bryanduxbury/cellular_chronometer/scad/button_flange.dxf

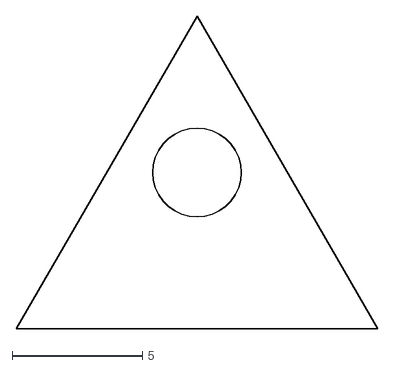
[picture p1: CAD file, 2014-02-02]
scad/button_flange.dxf
13.9 x 12.0
