bryanduxbury/cellular_chronometer/scad/support.dxf

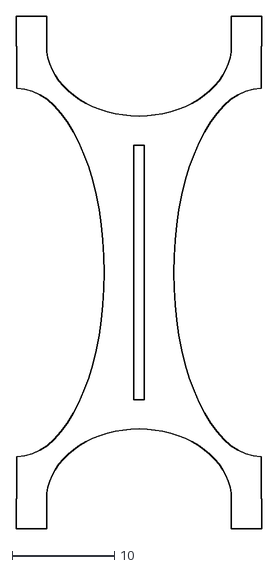
[picture p2: CAD file, 2014-02-02]
scad/support.dxf
24.0 x 50.1
