bryanduxbury/cellular_chronometer/scad/side.dxf

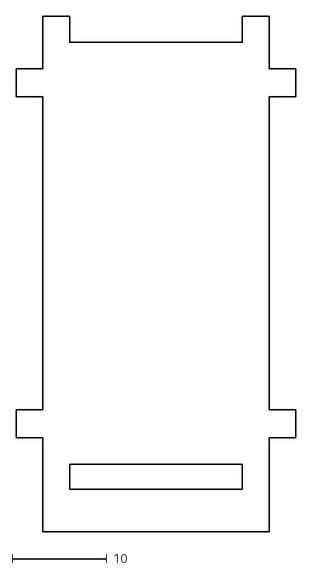
[picture p3: CAD file, 2014-02-02]
scad/side.dxf
29.5 x 54.4
