bryanduxbury/cellular_chronometer/scad/button.dxf

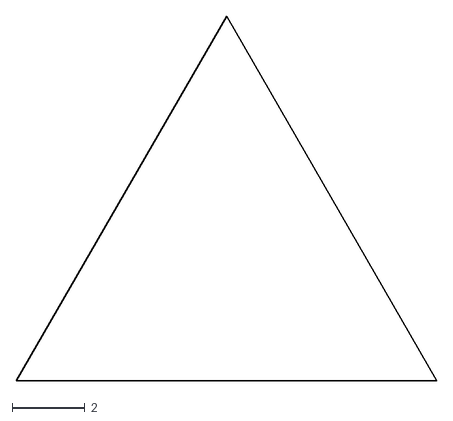
[picture p4: CAD file, 2014-02-02]
scad/button.dxf
11.5 x 10.0
