bryanduxbury/cellular_chronometer/scad/back.dxf

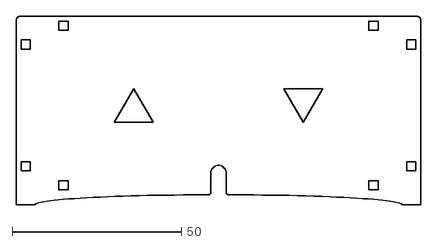
[picture p5: CAD file, 2014-02-02]
scad/back.dxf
119.6 x 55.8
