bryanduxbury/cellular_chronometer/scad/topbottom.dxf

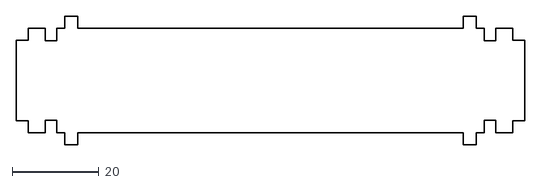
[picture p6: CAD file, 2014-02-02]
scad/topbottom.dxf
116.9 x 29.5
