bryanduxbury/cellular_chronometer/scad/front.dxf

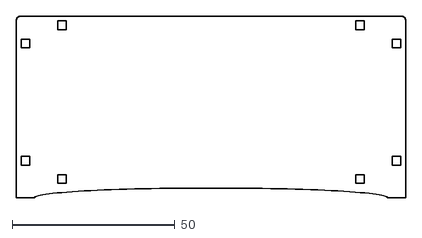
[picture p7: CAD file, 2014-02-02]
scad/front.dxf
119.6 x 55.8
