bryanduxbury/cellular_chronometer/eagle/charlie_array_v1/charlie_array_0805_v1.brd

## EAGLE design eagle/charlie_array_v1/charlie_array_0805_v1.brd (2013-08-26)

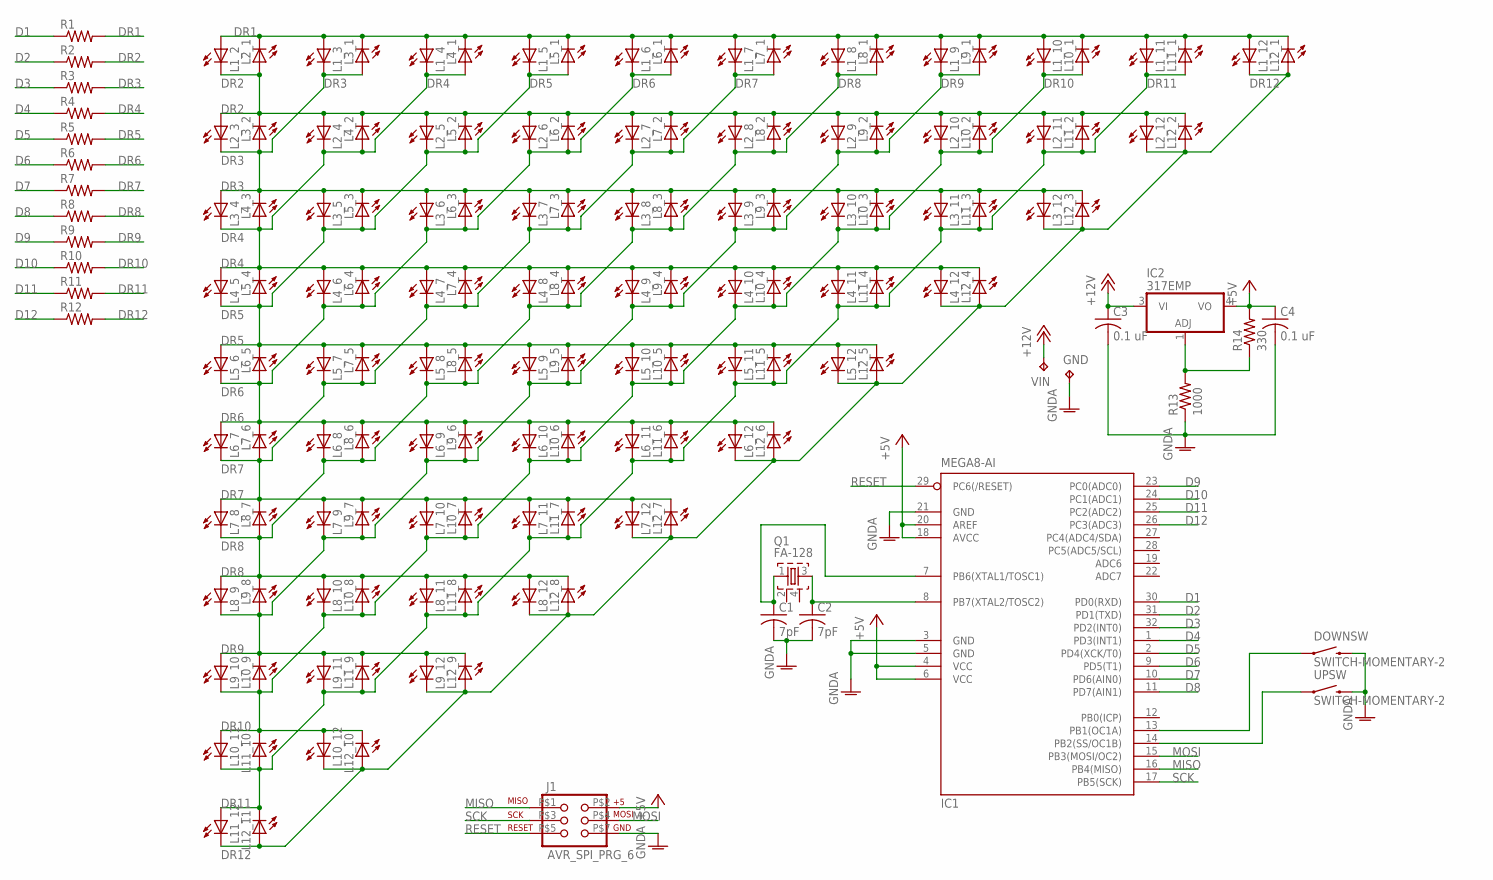
[picture p8: schematic charlie_array_0805_v1.sch]

Parts:
C1, C2: 7pF; C0603
C3, C4: 0.1 uF; C0603
DOWNSW: SWITCH-MOMENTARY-2; TACTILE_SWITCH_TALL
GND: TPTP20SQ; TP20SQ
IC1: MEGA8-AI; TQFP32-08
IC2: 317EMP; SOT223
J1: AVR_SPI_PRG_6; 2X3_ICSP_SMD
L1_2, L1_3, L1_4, L1_5, L1_6, L1_7, L1_8, L1_9, L1_10, L1_11, L1_12, L2_1, L2_3, L2_4, L2_5, L2_6, L2_7, L2_8, L2_9, L2_10, L2_11, L2_12, L3_1, L3_2, L3_4, L3_5, L3_6, L3_7, L3_8, L3_9, L3_10, L3_11, L3_12, L4_1, L4_2, L4_3, L4_5, L4_6, L4_7, L4_8, L4_9, L4_10, L4_11, L4_12, L5_1, L5_2, L5_3, L5_4, L5_6, L5_7, L5_8, L5_9, L5_10, L5_11, L5_12, L6_1, L6_2, L6_3, L6_4, L6_5, L6_7, L6_8, L6_9, L6_10, L6_11, L6_12, L7_1, L7_2, L7_3, L7_4, L7_5, L7_6, L7_8, L7_9, L7_10, L7_11, L7_12, L8_1, L8_2, L8_3, L8_4, L8_5, L8_6, L8_7, L8_9, L8_10, L8_11, L8_12, L9_1, L9_2, L9_3, L9_4, L9_5, L9_6, L9_7, L9_8, L9_10, L9_11, L9_12, L10_1, L10_2, L10_3, L10_4, L10_5, L10_6, L10_7, L10_8, L10_9, L10_11, L10_12, L11_1, L11_2, L11_3, L11_4, L11_5, L11_6, L11_7, L11_8, L11_9, L11_10, L11_12, L12_1, L12_2, L12_3, L12_4, L12_5, L12_6, L12_7, L12_8, L12_9, L12_10, L12_11: LEDCHIPLED_0805; CHIPLED_0805
Q1: FA-128
R1, R2, R3, R4, R5, R6, R7, R8, R9, R10, R11, R12: R-US_R0603; R0603
R13: 1000; R0603
R14: 330; R0603
UPSW: SWITCH-MOMENTARY-2; TACTILE_SWITCH_TALL
VIN: TPTP20SQ; TP20SQ

Connections:
+5V: C4.1, IC1.4 (VCC), IC1.6 (VCC), IC1.18 (AVCC), IC1.20 (AREF), IC2.4 (VO), J1.P$2 (2), R14.2
+12V: C3.1, IC2.3 (VI), VIN.TP
D1: IC1.30 (PD0(RXD)), R1.1
D2: IC1.31 (PD1(TXD)), R2.1
D3: IC1.32 (PD2(INT0)), R3.1
D4: IC1.1 (PD3(INT1)), R4.1
D5: IC1.2 (PD4(XCK/T0)), R5.1
D6: IC1.9 (PD5(T1)), R6.1
D7: IC1.10 (PD6(AIN0)), R7.1
D8: IC1.11 (PD7(AIN1)), R8.1
D9: IC1.23 (PC0(ADC0)), R9.1
D10: IC1.24 (PC1(ADC1)), R10.1
D11: IC1.25 (PC2(ADC2)), R11.1
D12: IC1.26 (PC3(ADC3)), R12.1
DR1: L1_2.A, L1_3.A, L1_4.A, L1_5.A, L1_6.A, L1_7.A, L1_8.A, L1_9.A, L1_10.A, L1_11.A, L1_12.A, L2_1.C, L3_1.C, L4_1.C, L5_1.C, L6_1.C, L7_1.C, L8_1.C, L9_1.C, L10_1.C, L11_1.C, L12_1.C, R1.2
DR2: L1_2.C, L2_1.A, L2_3.A, L2_4.A, L2_5.A, L2_6.A, L2_7.A, L2_8.A, L2_9.A, L2_10.A, L2_11.A, L2_12.A, L3_2.C, L4_2.C, L5_2.C, L6_2.C, L7_2.C, L8_2.C, L9_2.C, L10_2.C, L11_2.C, L12_2.C, R2.2
DR3: L1_3.C, L2_3.C, L3_1.A, L3_2.A, L3_4.A, L3_5.A, L3_6.A, L3_7.A, L3_8.A, L3_9.A, L3_10.A, L3_11.A, L3_12.A, L4_3.C, L5_3.C, L6_3.C, L7_3.C, L8_3.C, L9_3.C, L10_3.C, L11_3.C, L12_3.C, R3.2
DR4: L1_4.C, L2_4.C, L3_4.C, L4_1.A, L4_2.A, L4_3.A, L4_5.A, L4_6.A, L4_7.A, L4_8.A, L4_9.A, L4_10.A, L4_11.A, L4_12.A, L5_4.C, L6_4.C, L7_4.C, L8_4.C, L9_4.C, L10_4.C, L11_4.C, L12_4.C, R4.2
DR5: L1_5.C, L2_5.C, L3_5.C, L4_5.C, L5_1.A, L5_2.A, L5_3.A, L5_4.A, L5_6.A, L5_7.A, L5_8.A, L5_9.A, L5_10.A, L5_11.A, L5_12.A, L6_5.C, L7_5.C, L8_5.C, L9_5.C, L10_5.C, L11_5.C, L12_5.C, R5.2
DR6: L1_6.C, L2_6.C, L3_6.C, L4_6.C, L5_6.C, L6_1.A, L6_2.A, L6_3.A, L6_4.A, L6_5.A, L6_7.A, L6_8.A, L6_9.A, L6_10.A, L6_11.A, L6_12.A, L7_6.C, L8_6.C, L9_6.C, L10_6.C, L11_6.C, L12_6.C, R6.2
DR7: L1_7.C, L2_7.C, L3_7.C, L4_7.C, L5_7.C, L6_7.C, L7_1.A, L7_2.A, L7_3.A, L7_4.A, L7_5.A, L7_6.A, L7_8.A, L7_9.A, L7_10.A, L7_11.A, L7_12.A, L8_7.C, L9_7.C, L10_7.C, L11_7.C, L12_7.C, R7.2
DR8: L1_8.C, L2_8.C, L3_8.C, L4_8.C, L5_8.C, L6_8.C, L7_8.C, L8_1.A, L8_2.A, L8_3.A, L8_4.A, L8_5.A, L8_6.A, L8_7.A, L8_9.A, L8_10.A, L8_11.A, L8_12.A, L9_8.C, L10_8.C, L11_8.C, L12_8.C, R8.2
DR9: L1_9.C, L2_9.C, L3_9.C, L4_9.C, L5_9.C, L6_9.C, L7_9.C, L8_9.C, L9_1.A, L9_2.A, L9_3.A, L9_4.A, L9_5.A, L9_6.A, L9_7.A, L9_8.A, L9_10.A, L9_11.A, L9_12.A, L10_9.C, L11_9.C, L12_9.C, R9.2
DR10: L1_10.C, L2_10.C, L3_10.C, L4_10.C, L5_10.C, L6_10.C, L7_10.C, L8_10.C, L9_10.C, L10_1.A, L10_2.A, L10_3.A, L10_4.A, L10_5.A, L10_6.A, L10_7.A, L10_8.A, L10_9.A, L10_11.A, L10_12.A, L11_10.C, L12_10.C, R10.2
DR11: L1_11.C, L2_11.C, L3_11.C, L4_11.C, L5_11.C, L6_11.C, L7_11.C, L8_11.C, L9_11.C, L10_11.C, L11_1.A, L11_2.A, L11_3.A, L11_4.A, L11_5.A, L11_6.A, L11_7.A, L11_8.A, L11_9.A, L11_10.A, L11_12.A, L12_11.C, R11.2
DR12: L1_12.C, L2_12.C, L3_12.C, L4_12.C, L5_12.C, L6_12.C, L7_12.C, L8_12.C, L9_12.C, L10_12.C, L11_12.C, L12_1.A, L12_2.A, L12_3.A, L12_4.A, L12_5.A, L12_6.A, L12_7.A, L12_8.A, L12_9.A, L12_10.A, L12_11.A, R12.2
GNDA: C1.2, C2.2, C3.2, C4.2, DOWNSW.B2 (2), GND.TP, IC1.3 (GND), IC1.5 (GND), IC1.21 (GND), J1.P$7 (6), R13.1, UPSW.B2 (2)
MISO: IC1.16 (PB4(MISO)), J1.P$1 (1)
MOSI: IC1.15 (PB3(MOSI/OC2)), J1.P$4 (4)
unnamed: C2.1, IC1.8 (PB7(XTAL2/TOSC2)), Q1.3
unnamed: IC1.14 (PB2(SS/OC1B)), UPSW.A2 (1)
unnamed: DOWNSW.A2 (1), IC1.13 (PB1(OC1A))
unnamed: C1.1, IC1.7 (PB6(XTAL1/TOSC1)), Q1.1
unnamed: IC2.1 (ADJ), R13.2, R14.1
RESET: IC1.29 (PC6(/RESET)), J1.P$5 (5)
SCK: IC1.17 (PB5(SCK)), J1.P$3 (3)

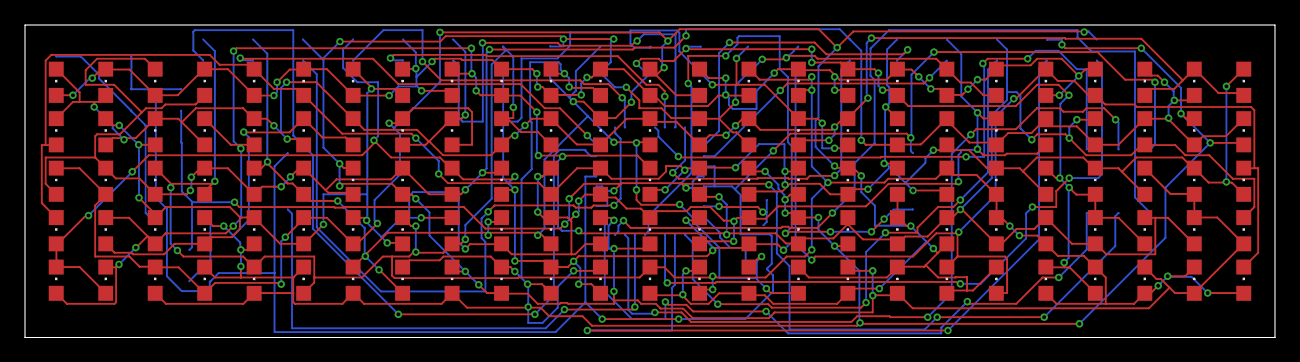
[picture p9: board charlie_array_0805_v1.brd from above]

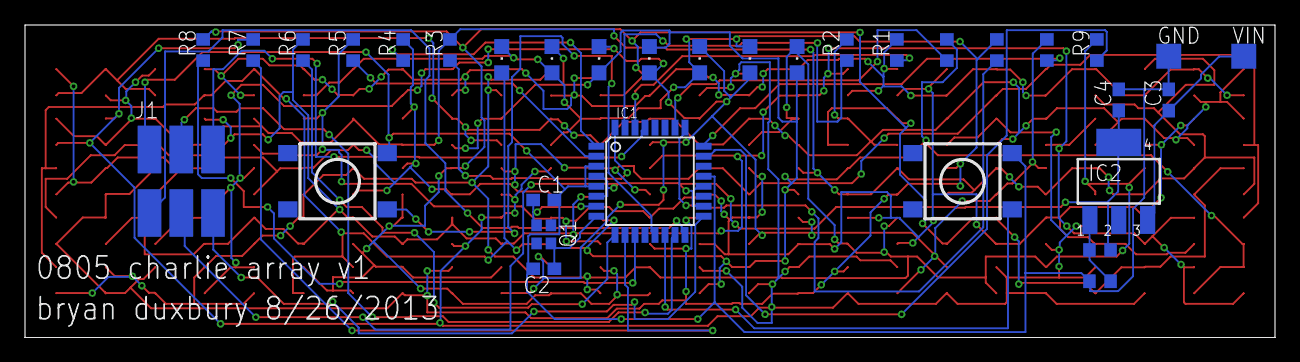
[picture p10: board charlie_array_0805_v1.brd from below]

Board: 2 copper layers, 100.0 x 25.0 mm, 158 parts (33 on the bottom side), 36 nets.
