bryanduxbury/cellular_chronometer/firmware/initial_states.h

#ifndef __INITIAL_STATES_H__
#define __INITIAL_STATES_H__

#define NUM_STATES 720

PROGMEM uint8_t initialStates[] = {
  18, 18, 24, 28, 25, 24, 12, 2, 8, 22, 4, 8, 24, 10, 14, 7, 30, 8, 9, 13, 5, 22, 11, 17, 18,  // 01_00.txt, 6 priors back
  16, 7, 14, 28, 5, 2, 13, 26, 14, 9, 0, 25, 2, 8, 19, 25, 16, 28, 10, 7, 16, 4, 1, 17, 8,  // 01_01.txt, 3 priors back
  14, 13, 1, 25, 17, 27, 18, 3, 21, 7, 1, 29, 1, 5, 3, 19, 24, 1, 20, 1, 8, 13, 6, 21, 8,  // 01_02.txt, 4 priors back
  14, 6, 17, 16, 11, 2, 30, 9, 2, 17, 3, 22, 10, 1, 0, 3, 30, 10, 6, 0, 16, 26, 6, 5, 8,  // 01_03.txt, 4 priors back
  22, 1, 1, 6, 25, 2, 28, 9, 7, 22, 24, 12, 26, 8, 6, 0, 25, 13, 7, 10, 16, 6, 2, 18, 27,  // 01_04.txt, 4 priors back
  2, 26, 2, 24, 23, 28, 0, 10, 13, 4, 29, 17, 8, 25, 16, 21, 10, 19, 17, 24, 0, 8, 10, 25, 5,  // 01_05.txt, 4 priors back
  28, 16, 4, 18, 4, 29, 9, 8, 7, 22, 8, 17, 20, 7, 6, 4, 0, 28, 9, 7, 2, 18, 17, 0, 5,  // 01_06.txt, 3 priors back
  5, 9, 1, 2, 30, 21, 21, 12, 1, 26, 2, 10, 12, 24, 3, 24, 4, 1, 6, 2, 1, 3, 1, 28, 12,  // 01_07.txt, 4 priors back
  23, 20, 17, 11, 8, 0, 16, 17, 8, 11, 15, 14, 0, 12, 16, 11, 6, 14, 24, 23, 16, 6, 8, 20, 16,  // 01_08.txt, 4 priors back
  0, 21, 31, 9, 24, 9, 13, 20, 24, 1, 25, 24, 21, 17, 0, 8, 23, 19, 4, 7, 16, 10, 14, 6, 14,  // 01_09.txt, 4 priors back
  30, 17, 13, 6, 4, 18, 1, 6, 10, 13, 21, 3, 5, 8, 28, 25, 26, 20, 1, 8, 19, 2, 31, 8, 2,  // 01_10.txt, 4 priors back
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
  23, 27, 1, 3, 2, 9, 21, 2, 13, 2, 2, 27, 10, 3, 4, 1, 13, 27, 1, 6, 28, 21, 12, 25, 0,  // 12_58.txt, 3 priors back
  3, 21, 28, 3, 25, 8, 13, 6, 20, 23, 3, 16, 0, 11, 31, 4, 0, 23, 13, 8, 13, 4, 8, 2, 7,  // 12_59.txt, 3 priors back
};

#endif
