bryanduxbury/cellular_chronometer/firmware/glyphs.h

#ifndef __GLYPHS_H__
#define __GLYPHS_H__

// 5 x 3 glyphs for each digit
PROGMEM uint8_t digitGlyphs[] = {
  31, 17, 31, // 0
  18, 31, 16, // 1
  29, 21, 23, // 2
  21, 21, 31, // 3
   7,  4, 31, // 4
  23, 21, 29, // 5
  31, 21, 29, // 6
   1, 29,  3, // 7
  31, 21, 31, // 8
  23, 21, 31 // 9
};

#endif
