bryanduxbury/cellular_chronometer/(commit log)

2013-07-09 game of life prototype
2013-08-16 added initial scad prototype, cleaned up some logic in sketch
    [prototype.scad]
2013-08-26 eagle files v1
    [charlie_array_0805_v1.GBL, charlie_array_0805_v1.GBO, charlie_array_0805_v1.GBP, charlie_array_0805_v1.GBS, charlie_array_0805_v1.GTL, charlie_array_0805_v1.GTO, charlie_array_0805_v1.GTP, charlie_array_0805_v1.GTS]
2013-08-26 adjusted to fit in 100mm width
    [charlie_array_0805_v1.brd]
2013-08-26 don't need these export files committed
    [charlie_array_0805_v1.GBL, charlie_array_0805_v1.GBO, charlie_array_0805_v1.GBP, charlie_array_0805_v1.GBS, charlie_array_0805_v1.GTL, charlie_array_0805_v1.GTO, charlie_array_0805_v1.GTP, charlie_array_0805_v1.GTS]
2013-09-21 working out issues on the new hardware
    [Charlie.cpp, Charlie.h, firmware.ino, life.h, test_sketch.ino]
2013-09-27 figured out a bug in living_neighbors
    [firmware.ino, life.h]
2013-09-29 switched over to 32 bit masking instead of crazy looping
2013-10-02 incremental progress on enclosure design
    [prototype.scad]
2013-10-26 fixed the issues with toroidal life (it's working now)
    [firmware.ino, initial_states.h, life.h]
2013-10-26 clean up some cruft; latch the 'next state' button so it doesn't run faster than humans can see
    [firmware.ino]
2013-10-27 prototypes for nice linear fade in/out and crossfade effects
2013-10-28 fixed version of 01_00
    [initial_states.h]
2013-10-29 woohoo, setting time through button press is working
2013-10-29 off by one error in fastMinuteDisplay
    [firmware.ino]
2013-10-29 get rid of the test driver loop
2013-10-30 oops, had a bug in seekDown()
    [firmware.ino]
2013-10-30 remove the num priors blob, since we no longer need that; remove supporting and test functions
    [firmware.ino, initial_states.h]
2013-10-30 fix some weird code formatting
    [initial_states.h]
2013-11-05 switch to a millis() based tick generator; remove cruft left over from other implementation
2014-01-09 enclosure wip
    [suspended_enclosure_v1.scad]
2014-01-11 looks like a good completed draft of the suspended enclosure
    [suspended_enclosure_v1.scad]
2014-01-12 narrow down the cord slot slightly
    [suspended_enclosure_v1.scad]
2014-01-18 add top-level rotate for animated gif
    [suspended_enclosure_v1.scad]
2014-01-30 adjust all the tab widths to (hopefully) get a decent interference fit
    [suspended_enclosure_v1.scad]
2014-02-02 adjusted a number of parameters to make the pieces fit together better
    [suspended_enclosure_v1.scad]
2014-02-03 rotate the switches to point out; clean up whitespace and unused code; add a todo
    [suspended_enclosure_v1.scad]
2014-02-06 fix the switch height parameter so the buttons will actually touch correctly; notch out the bottom piece slightly so the cord doesn't have such a sharp bend
    [suspended_enclosure_v1.scad]
2014-02-09 start the clock at 12; normalize the delays across the board; make the time-setting faster
